feffes/may_controller/enclosure/params.scad

// All dimensions in mm. Single source of truth — do not hardcode numbers in
// left.scad / right.scad / lib modules; pull them from here.
//
// Items marked "TBD verify" should be confirmed against datasheets or a
// physical part before printing. See ../../research/ for sources.

// ---------- build mode ----------
// metal_mode = true  → geometry targets a CNC'd 6061 aluminium billet
//                      (pocketed tray with integral posts, flat top plate).
// metal_mode = false → geometry targets FDM 3D print with M3 heat-set inserts.
// Both share the same params; metal_mode just selects different derived
// values and branches in lib/shell.scad.
metal_mode = true;

// screws_from selects which face the M3 screws insert from:
//   "top"    → screws enter the top plate, thread into posts rising from
//              the tray floor. Top plate has clearance + countersink on its
//              top face. Tray floor is solid.
//   "bottom" → screws enter the tray floor, thread into pendant posts
//              hanging from the underside of the top plate. Top plate has
//              no visible screws. Tray floor has clearance holes +
//              countersink on its bottom face.
// Same screw spec (M3 × 8 DIN 7991 flat-head) in both modes.
screws_from = "top";

// ---------- shell construction (carry-over from lfet.FCStd) ----------
wall_thickness         = metal_mode ? 2.5 : 2;   // outer wall
floor_thickness        = metal_mode ? 1.5 : 2;   // tray bottom (billet floor under PCB)
ledge_height           = 6;     // height of inner ledge above floor; PCB rests on top — sized to fit a bottom-mounted USB-A receptacle (5.7 mm) below the PCB
ledge_width            = 2;     // how far the ledge protrudes inward from the wall
bezel_above_plate      = 3;     // top shell extends this much above the plate (print mode)
shell_corner_radius    = 4;     // outer corner rounding
pcb_clearance          = 4.0;   // gap between PCB top and plate bottom — sized to house top-mounted USB-C (3.3 mm) above the PCB
top_edge_round         = 1.5;   // roundover radius on the top plate's outer top edge (palm comfort); 0 = sharp. Clamped to plate thickness in derived section.

// ---------- screw posts (FDM, M3 with brass heat-set inserts) ----------
// Used only when metal_mode = false. Kept defined so a printed fit-check
// version still compiles.
heatset_insert_dia     = 4.0;   // TBD verify against actual part (4.0-4.7 mm common)
heatset_insert_depth   = 5.0;   // length of the brass body
heatset_hole_dia       = 3.8;   // insert OD - 0.2; insert displaces plastic into threads
heatset_hole_depth     = 6.0;   // insert depth + 1 mm relief for displaced plastic
screw_post_outer_dia   = 8.0;   // boss OD >= 2x insert OD to avoid wall blowout
screw_clearance_dia    = 3.4;   // M3 free-fit through the top shell
edge_to_first_screw    = 9;     // 8 + ~1 mm clearance from boss edge to upper-cavity wall

// ---------- metal mode (CNC 6061 aluminium billet) ----------
// M3 tapped directly into the aluminium posts; no heat-set inserts.
// Screws are M3 flat-head countersunk (DIN 7991) so the head fits flush in
// the 1.5 mm top plate. M3 SHCS heads are too tall (3 mm) for this thickness.
metal_top_t                  = 1.5;  // top plate thickness; matches Choc v2 plate window
metal_min_internal_r         = 3.0;  // inner-corner radius = (end-mill dia)/2 + 0.1; spec for a 6 mm cutter
metal_post_d                 = 6.0;  // integral post OD; M3 tap-drill leaves 1.75 mm wall in 6061
metal_m3_tap_drill           = 2.5;  // M3 × 0.5 coarse
metal_m3_tap_depth           = 6.0;  // ≥ 2×D engagement
// 90° countersink, depth 1.5 in a 1.5 mm plate. For geometric consistency
// with a 90° cone above the 3.4 mm clearance hole, top_d must equal
// clearance_dia + 2 × depth = 6.4 mm. DIN 7991 M3 head (6.0 mm) fits with
// 0.2 mm radial clearance; head sits ~0.15 mm proud of the face.
metal_screw_csk_top_d        = 6.4;
metal_screw_csk_depth        = 1.5;
metal_chamfer                = 0.5;  // outer top-edge break; spec'd in docs, not modelled
metal_inner_corner_r         = max(metal_min_internal_r, shell_corner_radius - wall_thickness);

// ---------- Kailh Choc v2 (PG1353) ----------
choc_plate_cutout      = 13.97; // square cutout for switch retention
// In metal mode, the entire 1.5 mm plate IS the snug retention zone;
// collapses the upper "body clearance" step in choc_v2_full_cutout() to ~0.
choc_plate_thickness   = metal_mode ? metal_top_t : 1.2;  // TBD verify: 1.2-1.5 mm typical
choc_snap_notch        = 0.6;   // optional side notches for snap tabs
choc_pitch_x           = 18;    // TBD pick: 18 (Choc-native) or 19 (MX)
choc_pitch_y           = 17;
choc_socket_clearance  = 1.8;   // hot-swap socket protrudes ~1.8 mm above PCB
choc_stem_above_plate  = 5.0;
choc_body_clearance    = 15;    // larger cutout above plate for switch body

// ---------- arcade-style face buttons ----------
face_button_pitch      = 24;    // classic hitbox spacing
// Deliberate in-plane nudge of BOTH halves' button clusters, in the local
// (pre-mirror) frame, applied equally so the mirror-matched thumb + start
// buttons stay symmetric about the pair centreline (both inner edges are local
// x=160). The right shift also clears the split chamfer-corner post near [0,56]
// (~2.6 mm web at 6 mm). +x = toward the inner/split edge.
cluster_offset         = [6, 0];
// Inward nudge of the small top-row function buttons (start/select/home/A1-3 —
// the may_top_screws row), local frame, so the end button clears the top-corner
// post [9,123]. +x = toward centre; applied to the shared row so it reads as
// "in" on both mirrored halves. ~5 mm leaves a ~3.3 mm web.
aux_button_offset      = [5, 0];

// ---------- PCB ----------
pcb_thickness          = 1.6;
pcb_lateral_clearance  = 0.3;   // gap between PCB outer edge and upper-cavity wall

// ---------- OLED window (SSD1315 0.96" common module) ----------
// Through-cut in the top plate. Centre is in may.scad's local pre-mirror
// frame — same position on both halves, so the mirror puts the window
// in the top-left of the right controller and the top-right of the left,
// each facing outward toward its hand.
oled_window_w          = 26;            // TBD verify against actual module
oled_window_h          = 14;
oled_window_centre     = [130, 110];

// ---------- USB cutouts (inner edge of each half) ----------
// Two USB-C (host + inter-half I2C link) and one micro USB-A in series,
// centred on the inner long edge (x = 160 in may.scad local frame).
// Each cutout is a notch through the full wall thickness (in x) running
// from z = floor_thickness up to z = tray_height — open at the top of
// the wall so the receptacle's mouth elevation has some latitude until
// the PCB outline is drawn.
usb_c_w                = 9.0;   // USB-C panel cutout width along y (TBD verify)
usb_c_h                = 3.3;   // USB-C panel cutout height along z
usb_a_w                = 13.0;  // USB-A panel cutout width along y
usb_a_h                = 5.7;   // USB-A panel cutout height along z
usb_stack_centre_y     = 66;    // y of the stack centre (132/2 = mid-edge)
usb_inter_gap          = 7.0;   // gap between adjacent cutouts
// USB-C is top-mounted (body sits on PCB top, cutout bottom flush with
// PCB top). USB-A is bottom-mounted (body hangs below PCB, cutout top
// flush with PCB bottom). See bottom_mount[] in may_usb_wall_cutouts.

// ---------- lap-mount pivot (tray underside, flush) ----------
// Single-screw friction mount with a FLAT tray bottom: remove the screw and the
// controller sits flat on a table. Threads live in a short boss rising from the
// floor into the lower cavity, stopping just below the PCB. A 1/4"-20 screw
// enters from below (through the user's plate); the flat tray bottom is the
// friction face. Loosen to rotate to any angle, tighten to clamp.
pivot_mount        = true;     // re-declared in may.scad for the Customizer
pivot_centre       = [80, 66]; // x,y, local pre-mirror frame; footprint mid,
                               // mirror-invariant -> identical on both halves
pivot_boss_dia     = 16;       // internal boss OD; also the PCB-underside keep-out Ø
pivot_pcb_gap      = 0.5;      // gap between boss top and PCB underside

// 1/4"-20 UNC fastener (enters from below, through the user's plate)
pivot_screw_clear_dia = 6.8;   // 1/4" (6.35) free-fit through the floor (plastic)
pivot_tap_drill       = 5.1;   // #7 drill, 1/4-20 tap (metal_mode, tapped full depth)
pivot_insert_dia      = 9.6;   // short 1/4-20 heat-set pocket (plastic). TBD verify
pivot_insert_depth    = 6.4;   // short (~1/4") insert body length. TBD verify
// The user's plate supplies the rest: a flat top to clamp against and a 1/4-20
// screw/thumbscrew from below. No spigot (flat bottom by design).

// ---------- derived ----------
tray_height = floor_thickness + ledge_height + pcb_thickness + pcb_clearance;
top_thickness = metal_mode ? metal_top_t
                           : choc_plate_thickness + bezel_above_plate;
total_height = tray_height + top_thickness;
// boss rises into the lower cavity but stops short of the PCB; engagement depth
// = floor_thickness + rise. Clamped so it can never reach the PCB.
pivot_boss_rise = max(0, ledge_height - pivot_pcb_gap);  // ~5.5 mm
// clamp the top-edge roundover so it never exceeds the plate (metal top is 1.5 mm)
top_edge_round_eff = max(0, min(top_edge_round, top_thickness - 0.2));

// ---------- render quality ----------
$fa = 2;
$fs = 0.4;
