feffes/may_controller/enclosure/may.scad

// Single-piece recreation of ~/dev/splitproject/lfet.FCStd.
//
// Body outline, USB cutout, and panel screws are identical between the two
// halves of the FreeCAD file. Button positions come from Sketch (Body
// "Left Top") or Sketch001 (Body001 "Right Top"), shifted by (-10, -10) so
// origin sits at the bbox bottom-left.
//
// Two switch styles supported:
//   sanwa    — 24 mm + 30 mm round holes (faithful to FreeCAD)
//   choc_v2  — same positions, but Choc v2 stepped square cutouts
//
// CLI:  openscad -o may_right_top.stl  -D 'side="right"' -D 'part="top"'  may.scad
//       openscad -o may_left_tray.stl  -D 'side="left"'  -D 'part="tray"' may.scad
// GUI:  open this file, hit F5; toggle side / part / switch_style via Customizer.

include <params.scad>
use <lib/choc_v2.scad>
use <lib/sanwa.scad>
include <lib/clusters/may_face.scad>

// [left, right]
side = "right";

// [preview, top, tray, top_dxf]
// top_dxf emits a 2D projection of the top plate for CNC DXF export.
part = "preview";

// [sanwa, choc_v2]
// Controls the *button-cap hole shape in the top plate*, not the underlying
// switch. Default "sanwa" gives circular 24 mm / 30 mm holes — the right
// thing for arcade-style round keycaps whose stems plug into Choc v2
// switches on the PCB below. "choc_v2" cuts the 13.97 mm square plate
// cutout instead, only useful if you intend to mount Choc v2 switches
// directly to the top plate (we don't, in this design).
switch_style = "sanwa";

// [top, bottom]
// Which face the M3 screws insert from. "top" → screws come down through
// the top plate into posts rising from the tray floor (corner countersinks
// visible on the top face). "bottom" → screws come up through the tray
// floor into pendant posts hanging from the underside of the top plate
// (clean top, countersinks on the tray bottom). See params.scad for the
// full semantics; this declaration mirrors it so the OpenSCAD Customizer
// picks it up when may.scad is open.
screws_from = "bottom";

// Build target: metal (CNC 6061 aluminium) vs plastic (FDM + M3 heat-set
// inserts). Re-declared here (also in params.scad) so the OpenSCAD Customizer
// can toggle it — the Customizer only exposes top-level vars of the opened
// file, and this re-declaration after the include wins ("last assignment in
// scope wins"), same forwarding pattern as screws_from above. The derived dims
// in params.scad (top_thickness, tray_height, choc_plate_thickness) read
// metal_mode lazily, so this override propagates to them and to screw_post().
// Caveat: the use'd lib modules (choc_v2/sanwa) include params.scad standalone
// and won't follow this override — only relevant to the non-default
// switch_style = "choc_v2" direct-mount path.
metal_mode = true;

// Cut the OLED viewable-area window in the top plate. Turn off for a half with
// no OLED. Customizer checkbox (top-level var of the opened file); consumed only
// in may.scad scope, so no cross-include caveat like metal_mode.
oled_window = false;

// Central friction pivot on the tray underside for mounting to an external lap
// plate. Customizer checkbox; consumed only in may.scad scope.
pivot_mount = true;

raw_buttons_24 = (side == "left") ? may_left_buttons_24 : may_right_buttons_24;
raw_buttons_30 = (side == "left") ? may_left_buttons_30 : may_right_buttons_30;
buttons_24 = [for (p = raw_buttons_24) p + cluster_offset];
buttons_30 = [for (p = raw_buttons_30) p + cluster_offset];
aux_buttons = [for (p = may_top_screws) p + aux_button_offset];

// ---------- ergogen-generated layout (single source of truth) ----------
// The board outline and the keycap/aux button positions are authored ONCE in
// ../ergogen/config.yaml and consumed here as DXF (see may_outline_2d() and
// may_top()). Regenerate the DXFs with `just ergogen` (or `npx ergogen` in
// ../ergogen) before rendering. import() paths resolve relative to THIS file.
// Posts/pivot/USB stay defined below in SCAD: those drive parametric 3D features
// (tap holes, countersinks, bosses) that a flat DXF can't parameterise — ergogen
// still emits anchor_posts/anchor_pivot DXFs for reference, but the 3D mechanics
// live here.
ergogen_outline   = "../ergogen/output/outlines/outline_body.dxf";
ergogen_holes_dxf = (side == "left")
    ? "../ergogen/output/outlines/holes_left.dxf"
    : "../ergogen/output/outlines/holes_right.dxf";

// ---------- may body outline (fallback reference) ----------
// Width 160 × height 132, bottom-left chamfer from (70, 0) up to (0, 56).
// Kept for reference / offline fallback; the live outline now comes from the
// ergogen DXF above via may_outline_2d().
may_outline_pts = [
    [   0, 132 ],
    [ 160, 132 ],
    [ 160,   0 ],
    [  70,   0 ],
    [   0,  56 ],
];

// ---------- screw post positions in the tray ----------
// Five positions inset from the body, accounting for the chamfer.
chamfer_post_clear = 4;   // nudge off the chamfer vertex so the boss clears the angled wall
may_post_positions = [
    [edge_to_first_screw,        132 - edge_to_first_screw],   // top-left
    [160 - edge_to_first_screw,  132 - edge_to_first_screw],   // top-right
    [160 - edge_to_first_screw,        edge_to_first_screw],   // bottom-right
    // angled (chamfer) corner: two posts, one near each end of the chamfer,
    // replacing the old single mid-chamfer post at [42,42].
    [70 + chamfer_post_clear,    edge_to_first_screw],         // near [70,0] end
    [edge_to_first_screw,        56 + chamfer_post_clear],     // near [0,56] end
];

// Screw post: free-standing boss.
// metal_mode = true  → 6 mm OD integral post with blind M3 tap-drill hole.
// metal_mode = false → 8 mm OD printed boss with heat-set insert pocket.
// tap_at = "top"     → tapped hole opens at the post's top face (z = height).
// tap_at = "bottom"  → tapped hole opens at the post's bottom face (z = 0).
//                      Use this when the post hangs from the top plate and
//                      the screw threads up from below.
module screw_post(height, tap_at = "top") {
    eps = 0.01;
    hole_z = (tap_at == "top") ? height - metal_m3_tap_depth : -eps;
    hs_hole_z = (tap_at == "top") ? height - heatset_hole_depth : -eps;
    if (metal_mode) {
        difference() {
            cylinder(d = metal_post_d, h = height);
            translate([0, 0, hole_z])
                cylinder(d = metal_m3_tap_drill,
                         h = metal_m3_tap_depth + eps);
        }
    } else {
        difference() {
            cylinder(d = screw_post_outer_dia, h = height);
            translate([0, 0, hs_hole_z])
                cylinder(d = heatset_hole_dia,
                         h = heatset_hole_depth + eps);
        }
    }
}

// Board outline as a 2D profile, imported from the ergogen DXF (single source of
// truth). The DXF is the 5-edge chamfered polygon; OpenSCAD assembles it into a
// closed face that offset()/linear_extrude() consume just like the old polygon().
module may_outline_2d() {
    import(ergogen_outline);
}

// Negative for the lap-mount pivot: the flush 1/4-20 hole entering the tray
// bottom. metal → tap-drill the full depth; plastic → screw clearance up to a
// heat-set insert pocket open at the boss top (top-installed during assembly).
module may_pivot_negative() {
    eps = 0.01;
    boss_top = floor_thickness + pivot_boss_rise;
    translate([pivot_centre.x, pivot_centre.y, 0])
        if (metal_mode) {
            translate([0, 0, -eps])
                cylinder(d = pivot_tap_drill, h = boss_top + 2 * eps);
        } else {
            pocket_base = boss_top - pivot_insert_depth;
            // screw clearance from the bottom face up INTO the insert pocket; overlap
            // the pocket by eps so the two cuts merge (no coincident face across the bore)
            translate([0, 0, -eps])
                cylinder(d = pivot_screw_clear_dia, h = pocket_base + 2 * eps);
            // heat-set insert pocket, open at the boss top
            translate([0, 0, pocket_base])
                cylinder(d = pivot_insert_dia, h = pivot_insert_depth + eps);
        }
}

// Lap-mount pivot boss: rises from the floor top into the lower cavity (stops
// ~pivot_pcb_gap below the PCB) so the tray BOTTOM stays flat — remove the screw
// and the controller sits flat on a table. A 1/4-20 screw enters from below; the
// flat tray bottom is the friction face — loosen to rotate, tighten to lock any
// angle.
//   metal_mode = true  → boss tapped 1/4-20.
//   metal_mode = false → 1/4-20 heat-set insert pocketed at the boss top.
module may_pivot_boss() {
    eps = 0.01;
    translate([pivot_centre.x, pivot_centre.y, floor_thickness - eps])
        cylinder(d = pivot_boss_dia, h = pivot_boss_rise + eps);
}

module may_button_cutout(diameter) {
    if (switch_style == "choc_v2") {
        choc_v2_full_cutout();
    } else {
        // sanwa default
        eps = 0.01;
        translate([0, 0, -eps])
            cylinder(d = diameter, h = top_thickness + 2 * eps);
    }
}

// Top-plate solid: outline extruded to top_thickness with the top OUTER edge
// rounded over (radius top_edge_round_eff) for palm comfort. The bottom face
// stays flat/sharp so the plate seats flush on the tray walls.
module may_top_plate() {
    r = top_edge_round_eff;
    if (r <= 0) {
        linear_extrude(top_thickness) may_outline_2d();
    } else {
        union() {
            // straight body up to where the fillet starts
            linear_extrude(top_thickness - r) may_outline_2d();
            // rounded lip: inset outline ⊕ an upper hemisphere. At the lip base
            // the disk grows the inset outline back to the full outline (flush
            // with the body); going up it domes inward to the flat top face.
            translate([0, 0, top_thickness - r])
                minkowski() {
                    linear_extrude(0.01) offset(delta = -r) may_outline_2d();
                    difference() {                 // upper hemisphere of radius r
                        sphere(r);
                        translate([0, 0, -r]) cube(2 * r, center = true);
                    }
                }
        }
    }
}

module may_top() {
    eps = 0.01;
    difference() {
        may_top_plate();

        // ---- keycap + aux button holes ----
        // Positions are the single-source-of-truth ergogen layout.
        if (switch_style == "choc_v2") {
            // Direct Choc v2 mount (non-default): square plate cutouts at the
            // button centres + Ø2.4 aux plunger holes. Still driven by the SCAD
            // arrays, which are kept in sync with ergogen/config.yaml.
            for (xy = buttons_24)
                translate([xy.x, xy.y, 0]) may_button_cutout(24);
            for (xy = buttons_30)
                translate([xy.x, xy.y, 0]) may_button_cutout(30);
            for (xy = aux_buttons)
                translate([xy.x, xy.y, -eps])
                    cylinder(d = 2.4, h = top_thickness + 2 * eps);
        } else {
            // Sanwa default: round 24/30 mm keycap holes + Ø2.4 aux plunger
            // holes, imported as one stamp from ergogen (holes_<side>.dxf).
            translate([0, 0, -eps])
                linear_extrude(top_thickness + 2 * eps)
                    import(ergogen_holes_dxf);
        }

        // OLED viewable-area window (rectangular through-cut); optional
        if (oled_window)
            translate([oled_window_centre.x - oled_window_w/2,
                       oled_window_centre.y - oled_window_h/2,
                       -eps])
                cube([oled_window_w, oled_window_h, top_thickness + 2 * eps]);

        // corner screw clearances + top-face countersinks (only when
        // screws enter from above; with bottom-screws the top is solid here)
        if (screws_from == "top") {
            for (xy = may_post_positions) {
                translate([xy.x, xy.y, -eps])
                    cylinder(d = screw_clearance_dia, h = top_thickness + 2 * eps);
                // 90° countersink on the top face for DIN 7991 flat-head M3
                if (metal_mode)
                    translate([xy.x, xy.y, top_thickness - metal_screw_csk_depth])
                        cylinder(d1 = screw_clearance_dia,
                                 d2 = metal_screw_csk_top_d,
                                 h = metal_screw_csk_depth + eps);
            }
        }
    }

    // pendant posts hanging from the underside of the top plate, for screws
    // entering from below. Post bottom hovers 0.1 mm above the tray floor so
    // the plate clamps to the walls (not to the post bottom) when tightened.
    // The post passes through a Ø 6.4 mm clearance hole in the PCB; PCB
    // clamping is the press ring's job (see below), independent of this.
    if (screws_from == "bottom") {
        post_height = tray_height - floor_thickness - 0.1;
        for (xy = may_post_positions)
            translate([xy.x, xy.y, -post_height])
                screw_post(post_height, tap_at = "bottom");
    }

    // PCB press ring on plate underside — clamps PCB top down to the ledge.
    // Outer edge aligned with PCB outer edge (offset
    // wall_thickness + pcb_lateral_clearance from outline); inner edge at the
    // ledge inner edge (offset wall_thickness + ledge_width). The entire
    // inner long edge (x = 160) is omitted so the press ring doesn't crash
    // into the USB receptacle bodies — the remaining three edges' worth of
    // ring is plenty of clamping perimeter.
    {
        // eps from may_top()'s scope (top of module) is in scope here.
        press_height = pcb_clearance - 0.1;

        translate([0, 0, -press_height])
            linear_extrude(press_height)
                difference() {
                    difference() {
                        may_cavity_2d(wall_thickness + pcb_lateral_clearance);
                        may_cavity_2d(wall_thickness + ledge_width);
                    }
                    // remove the ring along the entire inner long edge
                    translate([160 - (wall_thickness + ledge_width) - eps, -eps])
                        square([wall_thickness + ledge_width + 2 * eps,
                                132 + 2 * eps]);
                }
    }
}

// Inward polygon offset that produces millable inner corner radii.
// Composes "shrink sharp by (d + R)" + "grow rounded by R" — a morphological
// opening that yields a net inward offset of d with all corners rounded to R.
// In print mode the original sharp offset is fine and corner radius doesn't matter.
module may_cavity_2d(d) {
    if (metal_mode)
        offset(r = metal_inner_corner_r)
            offset(delta = -(d + metal_inner_corner_r))
                may_outline_2d();
    else
        offset(delta = -d) may_outline_2d();
}

// USB-C panel cutout face: a stadium (rounded rectangle with semicircular
// ends), corner radius = h/2. 2D, drawn in XY with x=horizontal, y=vertical.
module usb_c_face_2d() {
    r = usb_c_h / 2;
    hull() {
        translate([+usb_c_w/2 - r, 0]) circle(r = r);
        translate([-usb_c_w/2 + r, 0]) circle(r = r);
    }
}

// USB-A panel cutout face: rectangle.
// 2D, drawn in XY with x=horizontal, y=vertical.
module usb_a_face_2d() {
    square([usb_a_w, usb_a_h], center = true);
}

// Three USB cutouts in series on the inner long edge (x = 160 in local
// frame; the right half's flip_if_right() puts these on its left side).
// Each cutout is shaped like the actual receptacle's panel opening — USB-C
// stadium for the two USB-C ports and a USB-A rectangle for the host port.
// All three are bottom-mounted (receptacle body hangs below the PCB), so
// each cutout's top sits at PCB bottom and the cutouts are clustered in
// the lower half of the shell side. wall_depth spans both wall
// thicknesses since the cutouts straddle the ledge top.
module may_usb_wall_cutouts() {
    eps = 0.01;
    widths       = [usb_c_w, usb_c_w, usb_a_w];
    heights      = [usb_c_h, usb_c_h, usb_a_h];
    is_usb_c     = [true,    true,    false  ];
    bottom_mount = [true,    true,    true   ];
    stack_h = widths[0] + widths[1] + widths[2] + 2 * usb_inter_gap;
    top_y = usb_stack_centre_y + stack_h / 2;
    c0 = top_y - widths[0] / 2;
    c1 = c0 - widths[0]/2 - usb_inter_gap - widths[1]/2;
    c2 = c1 - widths[1]/2 - usb_inter_gap - widths[2]/2;
    centres = [c0, c1, c2];
    pcb_bottom = floor_thickness + ledge_height;
    pcb_top    = pcb_bottom + pcb_thickness;
    wall_depth = wall_thickness + ledge_width;

    for (i = [0 : len(widths) - 1])
        let (z_centre = bottom_mount[i]
                ? pcb_bottom - heights[i]/2
                : pcb_top    + heights[i]/2)
        translate([160 - wall_depth - eps, centres[i], z_centre])
            // rotate([90,0,90]) is the cyclic axis permutation
            // (local X→world Y, local Y→world Z, local Z→world X), so the
            // 2D shape's horizontal becomes world Y, vertical becomes world Z,
            // and the extrusion runs along world +X through the wall.
            rotate([90, 0, 90])
                linear_extrude(height = wall_depth + 2 * eps)
                    if (is_usb_c[i]) usb_c_face_2d();
                    else             usb_a_face_2d();
}

module may_tray() {
    eps = 0.01;
    difference() {
        linear_extrude(tray_height) may_outline_2d();

        // lower cavity (between floor and ledge top) — narrow; the thicker
        // lower wall forms a step-up ledge that the PCB rests on from above.
        translate([0, 0, floor_thickness])
            linear_extrude(ledge_height + eps)
                may_cavity_2d(wall_thickness + ledge_width);

        // upper cavity (above ledge — wide, PCB drops in through this opening)
        translate([0, 0, floor_thickness + ledge_height])
            linear_extrude(tray_height - floor_thickness - ledge_height + eps)
                may_cavity_2d(wall_thickness);

        // USB cutouts through the inner long edge
        may_usb_wall_cutouts();

        // Drop the inward-extrusion part of the lower wall (the 2 mm strip
        // that forms the ledge) in the USB area, so the inner-edge wall is
        // uniformly wall_thickness-thick across the receptacle stack. Bounded
        // to a y range that hugs the USB stack with a small margin; the
        // other three edges (and y outside this band) keep their ledge for
        // PCB support. The cuboid overlaps both adjacent cavities by eps to
        // avoid coplanar faces (which would otherwise render as a flickering
        // sliver of "wall" in F5 preview).
        {
            margin = 2;
            stack_y = usb_c_w + usb_c_w + usb_a_w + 2 * usb_inter_gap;
            y_lo = usb_stack_centre_y - stack_y/2 - margin;
            y_hi = usb_stack_centre_y + stack_y/2 + margin;
            translate([160 - (wall_thickness + ledge_width) - eps,
                       y_lo,
                       floor_thickness - eps])
                cube([ledge_width + 2 * eps,
                      y_hi - y_lo,
                      tray_height - floor_thickness + 2 * eps]);
        }

        // floor clearance holes + bottom-face countersinks (only when
        // screws enter from below; with top-screws the floor is solid here)
        if (screws_from == "bottom") {
            for (xy = may_post_positions) {
                // through-clearance through the entire floor
                translate([xy.x, xy.y, -eps])
                    cylinder(d = screw_clearance_dia,
                             h = floor_thickness + 2 * eps);
                // 90° countersink on the bottom face (wide at z=0, narrow upward)
                if (metal_mode)
                    translate([xy.x, xy.y, -eps])
                        cylinder(d1 = metal_screw_csk_top_d,
                                 d2 = screw_clearance_dia,
                                 h = metal_screw_csk_depth + eps);
            }
        }

        // pierce the floor for the central lap-mount pivot hole
        if (pivot_mount) may_pivot_negative();
    }

    // floor-mounted screw posts (only when screws enter from above)
    if (screws_from == "top")
        for (xy = may_post_positions)
            translate([xy.x, xy.y, floor_thickness])
                screw_post(tray_height - floor_thickness);

    // central lap-mount pivot boss, rising into the lower cavity (flat bottom)
    if (pivot_mount)
        difference() { may_pivot_boss(); may_pivot_negative(); }
}

// Right half mirrors the left around x = 160/2 so the chamfer ends up on the
// bottom-right corner — the two halves form a mirror-symmetric pair.
module flip_if_right() {
    if (side == "right")
        translate([160, 0, 0]) mirror([1, 0, 0]) children();
    else
        children();
}

if      (part == "top")     flip_if_right() may_top();
else if (part == "tray")    flip_if_right() may_tray();
else if (part == "top_dxf") projection(cut = false) flip_if_right() may_top();
else {
    flip_if_right() may_tray();
    color("DimGray", 0.6)
        translate([0, 0, tray_height])
            flip_if_right() may_top();
}
