feffes/may_controller/(commit log)

2026-05-22 better ledges
    [may.scad, params.scad]
2026-05-22 snapshot build STLs after lip cutout fix
    Lip-cutout cuboid in may_tray now overlaps both adjacent cavities by
    eps, eliminating the coplanar faces that caused a flickering thin-wall
    artifact in F5 preview.
    [may.scad, may_left_top.stl, may_left_tray.stl, may_right_top.stl, may_right_tray.stl]
2026-05-22 more stls
    [may_left_assembled.stl, may_left_assembled_bs.stl, may_left_top.stl, may_left_top_bs.stl, may_left_tray.stl, may_left_tray_bs.stl, may_right_assembled.stl, may_right_assembled_bs.stl]
2026-05-25 step files
    [may_left_tray.step, may_left_tray_bs.step, may_right_tray.step, may_right_tray_bs.step]
2026-06-13 more progress
    [may.scad, params.scad]
2026-06-13 fix bottom hatching
    [may.scad, params.scad]
2026-06-14 More build variants
    [may.scad, may_left_assembled.stl, may_left_assembled_bs.stl, may_left_top.step, may_left_top.stl, may_left_top_bs.step, may_left_top_bs.stl, may_left_tray.step]
2026-06-14 pcb prep
    [may.scad]
